vadrianrc/G2-SA253J/diseno_toma_1.pdf

Manantial de Ladera y Concentrado, cuyo rendimiento es el siguiente:

Caudal de Aforo | = | 0.830 | l/s.
Caudal Máximo Diario | = | 0.180 l/s. | (Dato de cálculo de dotación)

1.- Cálculo de la distancia entre el punto de afloramiento y la cámara húmeda (L)

1/2

Donde
h0 = Altura entre el afloramiento y el orificio de entrada (se recomiendan valores de 0.4 a 0.5 m.) g = Aceleración de la gravedad en m/s2
v2 = Velocidad de pase (se recomiendan valores menores o iguales a 0.6 m/s.)
2 x 9.81 | x 0.4 | 0.5
v2 | = | = | 2.2429 m/s.
1.56

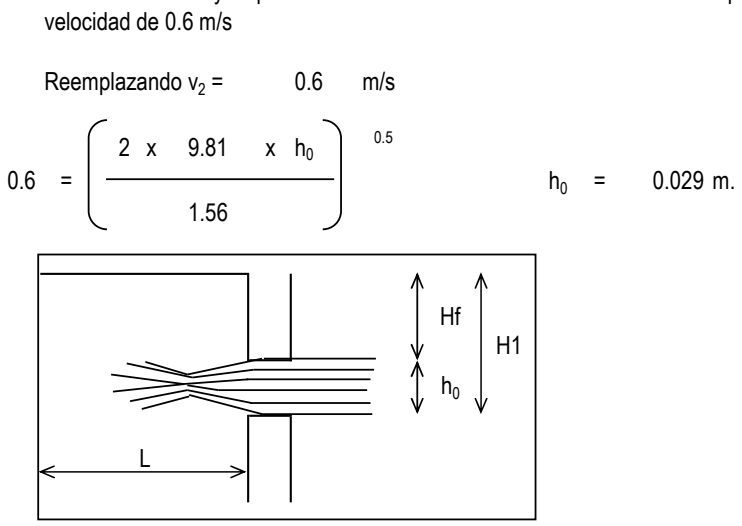
[picture p1: figure]
Reemplazando v2; velocidad de 0.6 m/s

Figura Nro. 01: Carga disponible y perdida de carga En la figura se observa:

"MEJORAMIENTO DEL SISTEMA DE AGUA POTABLE Y ALCANTARILLADO DE LA LOCALIDAD DE PUSACPAMPA, DISTRITO DE COMAS - DISTRITO DE COMAS - PROVINCIA DE CONCEPCION - REGIÓN JUNÍN"

DISEÑO CAPTACIÓN DE LADERA (PUSACPAMPA 1)

2gh0

1.56

v2 =

Dicho valor es mayor que la velocidad máxima recomendada de 0.6 m/s por lo que se asume para el diseño una

"MEJORAMIENTO DEL SISTEMA DE AGUA POTABLE Y ALCANTARILLADO DE LA LOCALIDAD DE PUSACPAMPA, DISTRITO DE COMAS - DISTRITO DE COMAS - PROVINCIA DE CONCEPCION - REGIÓN JUNÍN"

DISEÑO CAPTACIÓN DE LADERA (PUSACPAMPA 1)

Hf = H1 | - | h0 | y | L | = | Hf | / | 0.3
Reemplazando Valores
Hf = | 0.24 - 0.029 = | 0.21 m. | y | L = | 0.21 / 0.3 | = | 0.70 | m.
2.- Ancho de pantalla (b)

Cálculo del diámetro de la tubería de entrada (D)

El valor de área está definida como:

considerando:
Cd | = Coeficiente de descarga | 0.6 | a | 0.8
Qmáx | = | 0.83 l/s.
V | = | 0.60 m/s.
Cd | = | 0.7
Reemplazando valores se obtiene:

### 0.7 x 0.6

El diámetro del orificio está definido mediante:

| 1/2
4 x | 1/2
D = | 5.02 cm. | = | 1.97 "

Calculo del número de orificios (NA)

D Calculado | > D Recomendado
D asum. = | 1 | D recom. | = | 2.54 | cm

D

2
| (3/4 ")

D

4A
π

1.98E-03

1

=

= | = | = | 1.98E-03 1.9762 | l/m.
= | 0.0502 | m.

D

2
(4/7")

m

2

=

### 0.83 A

Qmáx
Cd x V

3.14159 D =

NA = | +

A

"MEJORAMIENTO DEL SISTEMA DE AGUA POTABLE Y ALCANTARILLADO DE LA LOCALIDAD DE PUSACPAMPA, DISTRITO DE COMAS - DISTRITO DE COMAS - PROVINCIA DE CONCEPCION - REGIÓN JUNÍN"

DISEÑO CAPTACIÓN DE LADERA (PUSACPAMPA 1)

25.16
6.45
Cálculo de ancho de pantalla (b) b = 9*D+4*N°A*D
b | = | cm.
Entonces se asume:
b | = | m.

3.- Cálculo de la cámara húmeda (Ht)

Utilizando la ecuación:
Ht = A + B + H + D + E | Min=0.30m
Donde:
A = | 10 cm.
B = | 2.54 cm. 1 | " | Es el diámetro de la tubería de salida a la línea de conducción.
D = | 5 cm.
E = | 30 cm. | Borde libre (min=0.30m)
El valor de la carga requerida (H) se define mediante la ecuación:

### 2 g A

2

Donde:
Qmd | = | m

3
/s. Gasto máximo diario
A | = | m

2
. | Área de la Tuberia de salida
g | = | 9.81 | m/s²
. Aceleración gravitacional Reemplazando Valores se obtiene:

2 9.81

H | = | cm.
H | = | cm. | H=0.30; Altura mínima para facilitar el paso del agua.
NA = | 1 + | = | 4.90 | 4

=

H

Q

2md 1.56

Asumiendose NA =

63.5

0.70

H | 0.0100 | m. 2.56752E-07

Desnivel mínimo entre el ingreso del agua de afloramiento y el nivel de agua de la cámara húmeda.

1.56

=

1.003

30.00

0.00018
0.0005

=

3.24E-08

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

DISEÑO CAPTACIÓN DE LADERA (PUSACPAMPA 1)

Entonces:

Ht | = | + 2.54 + | 30 | + | 5 | + | 30
Ht = | cm. | = | 0.8 m.

En el diseño se considera:

Ht = | | m.

4.- Dimensionamiento de la canastilla

NOTA: Estas dimensiones se obtienen en funcion al caudal Máximo diario que la poblacion requiere.

Qmax diario =

Cálculo del diámetro de la tubería de entrada (D)

El valor de área está definida como:

considerando:
Cd | = Coeficiente de descarga | 0.6 | a | 0.8
Qmáx | = | 0.18 l/s.
V | = | 0.60 m/s.
Cd | = | 0.8
Reemplazando valores se obtiene:

### 0.8 x 0.6

El diámetro del orificio está definido mediante:

| 1/2
4 x | 1/2
=
3.75E-04 | =

0.80

m

2

77.54

0.375 | l/m. | =

=

Qmáx
Cd x V

10

0.180

0.18 | = | 3.75E-04

A

A =

D = 4A
π
D | 0.0219 | m. 3.14159

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

DISEÑO CAPTACIÓN DE LADERA (PUSACPAMPA 1)

D = 2.1851 cm. | = | 0.86 " | = | 1 | Por cálculo hidráulico
D canastilla = | 2 | x | = | 2 "

La longitud de la canastilla debe ser:

3Dc < L < | 6Dc
L = | 3 x | 1.00 = | 7.62 = | 8 cm.
L = | 6 x | 1.00 = | 15.24 = | 15 cm.
L = | 20 cm. | Asumido
Ancho de ranura | = | 10 mm
Largo de ranura | = | 7.5 mm
siendo el área de ranura (Ar) | = | 7.5 | x | 10 = | 75 mm²

Ar =

π | x Dc² | 3.14 | x | 6
At = | 2 x Ac | At | = | 2 x | = | m

2

5.- Rebose y Limpia

0.71 x | Q 0.38 | Hf | = | 0.015 | m/m Perdida de carga unitaria

Hf 0.21

### 0.71 x 0.913 0.38

0.21

Entonces el diámetro de la tubería de rebose será | = | 2 | Pulgada
| | | | = | 2.00

=

At
Ar | 0.000075

m

2

0.00050671 | 0.00101
Ac | = | 4

=

= 14 0.001013415

0.000075

4

= 1.66

0.000507

Nº de ranuras | =

0.015

D =

D =

Ac =

1.00
