vadrianrc/G2-SA253J/aforo_pusacpampa_1.png

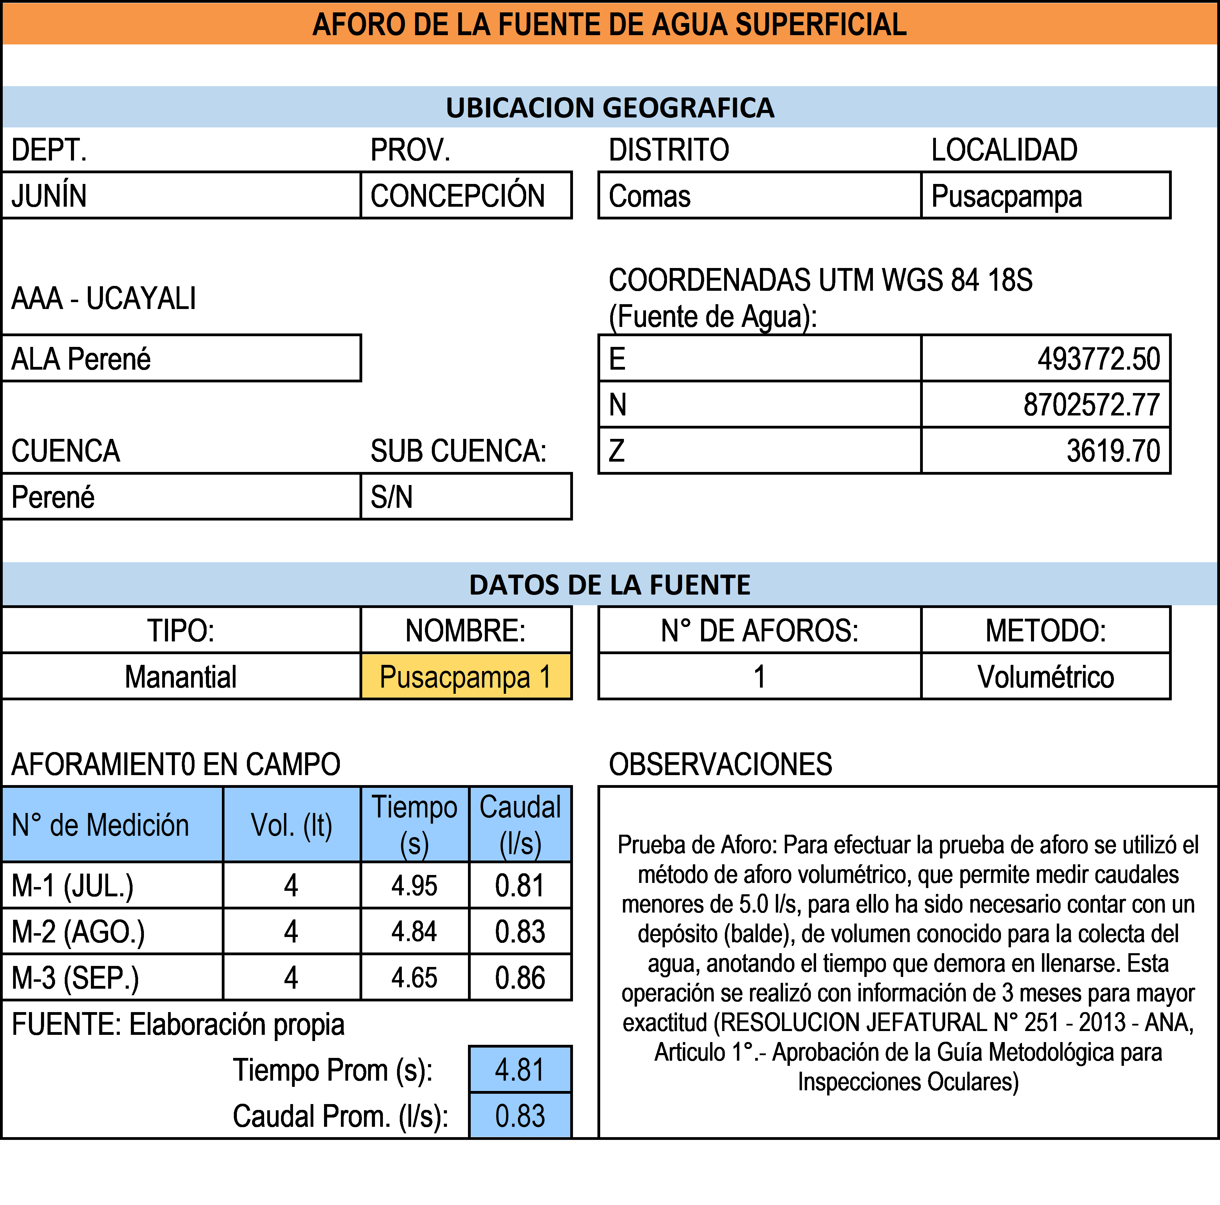
aforo_pusacpampa_1.png
