vadrianrc/G2-SA253J/caseta_cloracion.png

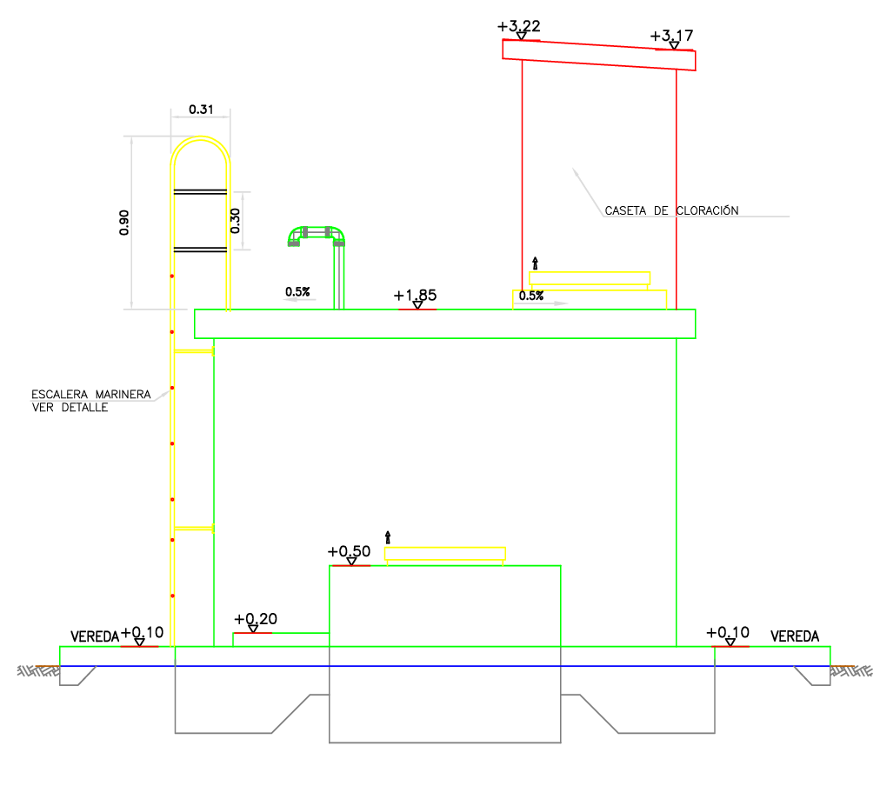
caseta_cloracion.png
