vadrianrc/G2-SA253J/(list of files, cad)

Other CAD files:
Reservorio Apoyado 5 m3.dwg
