vadrianrc/G2-SA253J/reservorio_plano.pdf

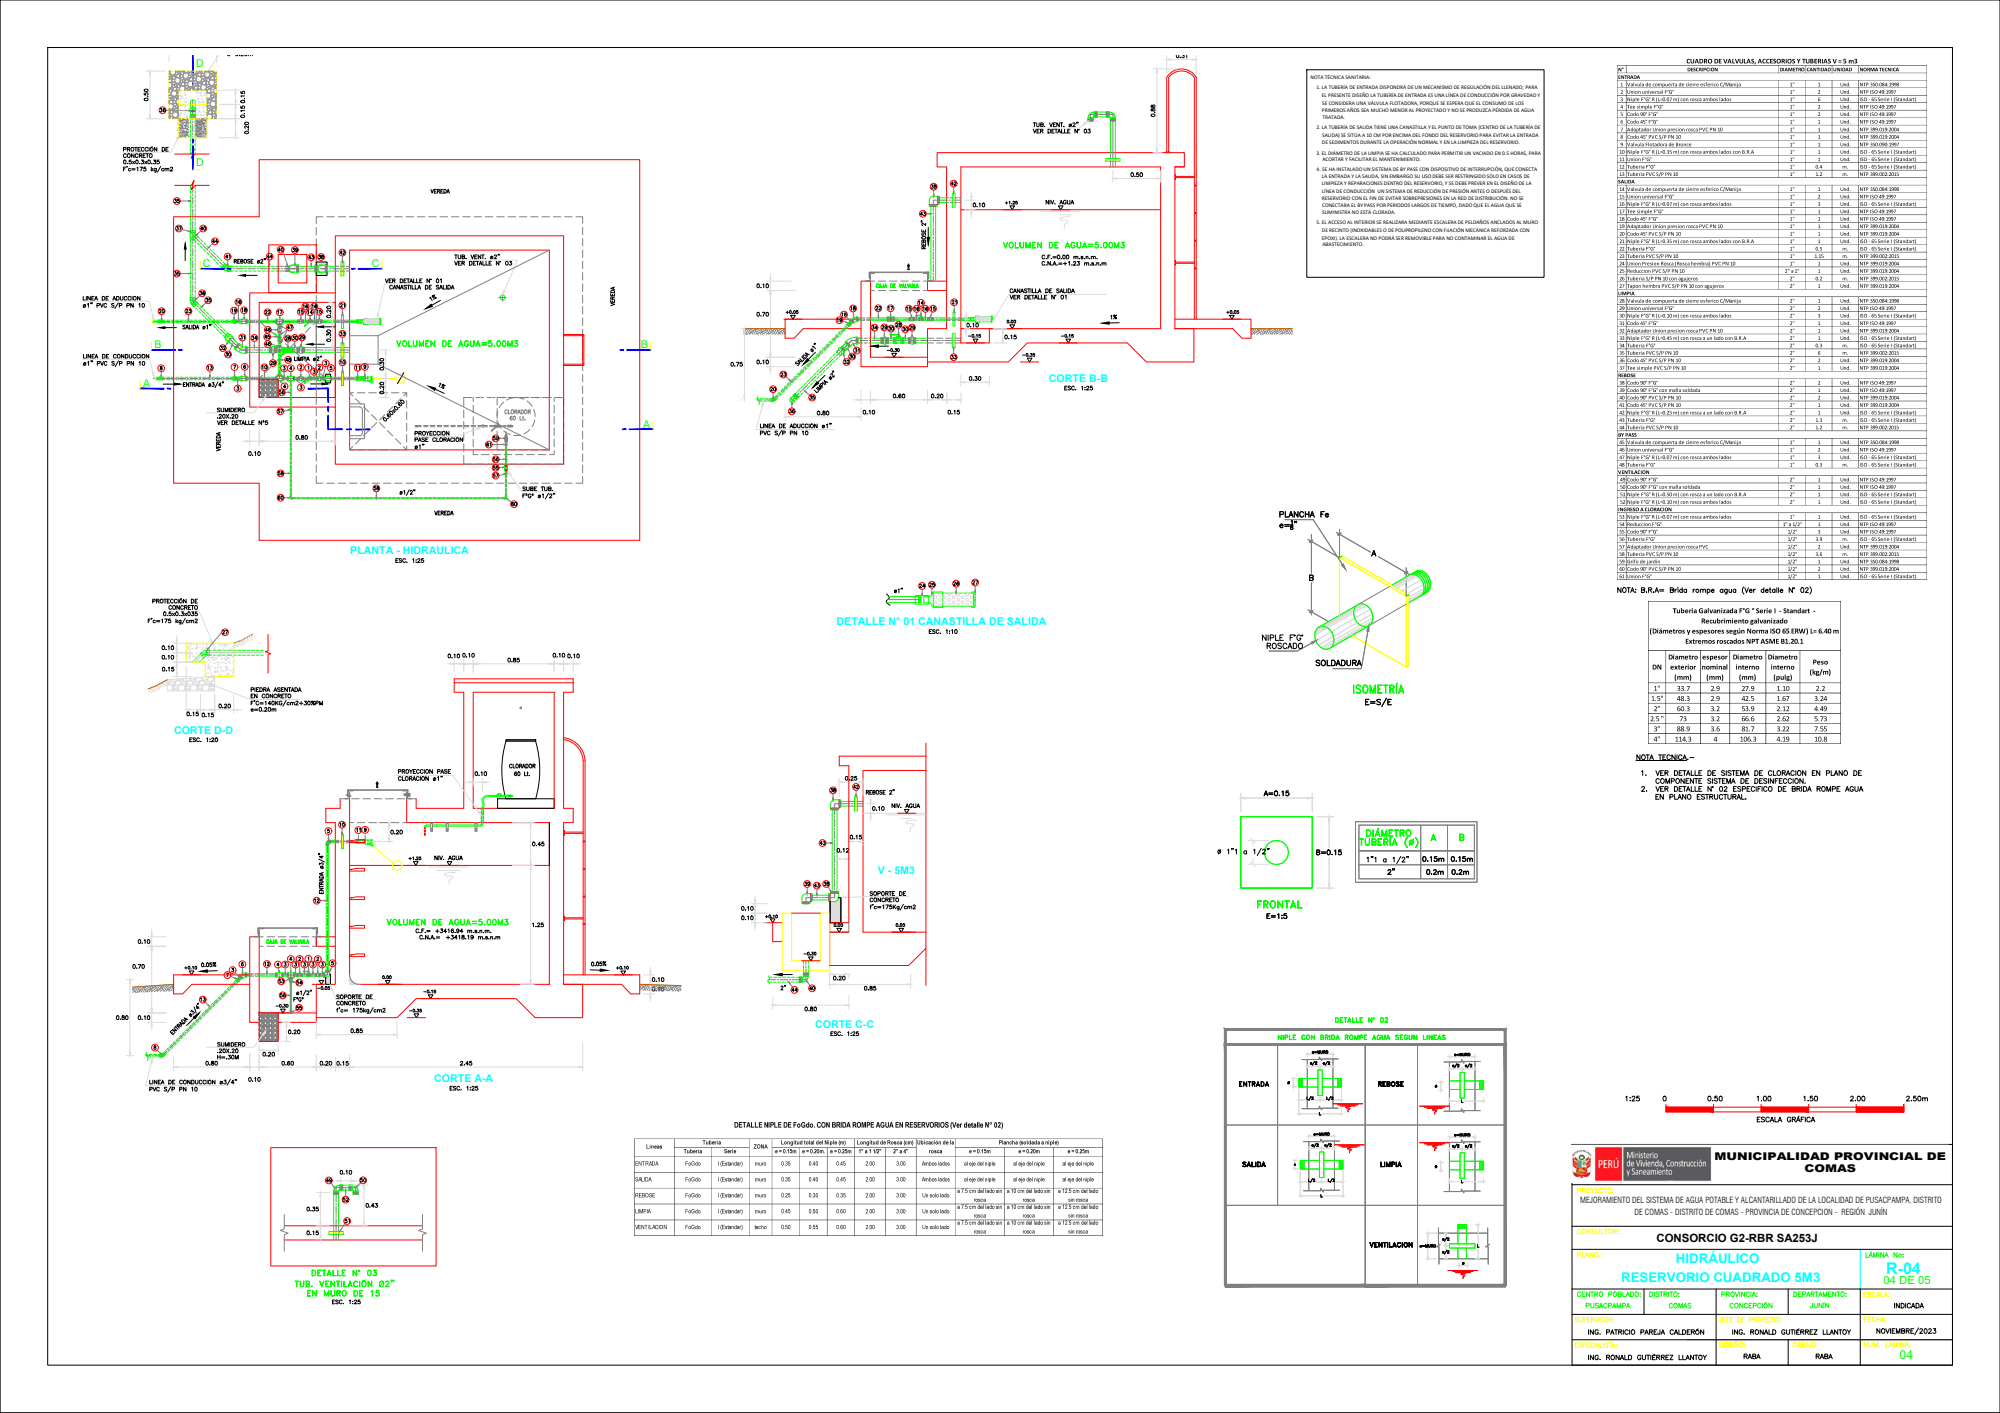
[picture p4: page 1]
CORTE A-A; CORTE B-B; PLANTA - HIDRAULICA; CORTE C-C; CORTE D-D; RESERVORIO CUADRADO 5M3; CONSORCIO G2-RBR SA253J

NOTA TÉCNICA SANITARIA: 1. LA TUBERÍA DE ENTRADA DISPONDRÁ DE UN MECANISMO DE REGULACIÓN DEL LLENADO; PARA

EL PRESENTE DISEÑO LA TUBERÍA DE ENTRADA ES UNA LÍNEA DE CONDUCCIÓN POR GRAVEDAD Y
SE CONSIDERA UNA VÁLVULA FLOTADORA, PORQUE SE ESPERA QUE EL CONSUMO DE LOS
PRIMEROS AÑOS SEA MUCHO MENOR AL PROYECTADO Y NO SE PRODUZCA PÉRDIDA DE AGUA
TRATADA. 2. LA TUBERÍA DE SALIDA TIENE UNA CANASTILLA Y EL PUNTO DE TOMA (CENTRO DE LA TUBERÍA DE

SALIDA) SE SITÚA A 10 CM POR ENCIMA DEL FONDO DEL RESERVORIO PARA EVITAR LA ENTRADA
DE SEDIMENTOS DURANTE LA OPERACIÓN NORMAL Y EN LA LIMPIEZA DEL RESERVORIO. 3. EL DIÁMETRO DE LA LIMPIA SE HA CALCULADO PARA PERMITIR UN VACIADO EN 0.5 HORAS, PARA

ACORTAR Y FACILITAR EL MANTENIMIENTO. 4. SE HA INSTALADO UN SISTEMA DE BY PASS CON DISPOSITIVO DE INTERRUPCIÓN, QUE CONECTA

LA ENTRADA Y LA SALIDA, SIN EMBARGO SU USO DEBE SER RESTRINGIDO SOLO EN CASOS DE
LIMPIEZA Y REPARACIONES DENTRO DEL RESERVORIO, Y SE DEBE PREVER EN EL DISEÑO DE LA
LÍNEA DE CONDUCCIÓN UN SISTEMA DE REDUCCIÓN DE PRESIÓN ANTES O DESPUÉS DEL
RESERVORIO CON EL FIN DE EVITAR SOBREPRESIONES EN LA RED DE DISTRIBUCIÓN. NO SE
CONECTARA EL BY PASS POR PERIODOS LARGOS DE TIEMPO, DADO QUE EL AGUA QUE SE
SUMINISTRA NO ESTÁ CLORADA. 5. EL ACCESO AL INTERIOR SE REALIZARA MEDIANTE ESCALERA DE PELDAÑOS ANCLADOS AL MURO

DE RECINTO (INOXIDABLES O DE POLIPROPILENO CON FIJACIÓN MECÁNICA REFORZADA CON
EPOXI). LA ESCALERA NO PODRÁ SER REMOVIBLE PARA NO CONTAMINAR EL AGUA DE ABASTECIMIENTO.

DETALLE N° 01 CANASTILLA DE SALIDA

MUNICIPALIDAD PROVINCIAL DE

MEJORAMIENTO DEL SISTEMA DE AGUA POTABLE Y ALCANTARILLADO DE LA LOCALIDAD DE PUSACPAMPA, DISTRITO

DE COMAS - DISTRITO DE COMAS - PROVINCIA DE CONCEPCION - REGIÓN JUNÍN
