vadrianrc/G2-SA253J/plano_tomas.pdf

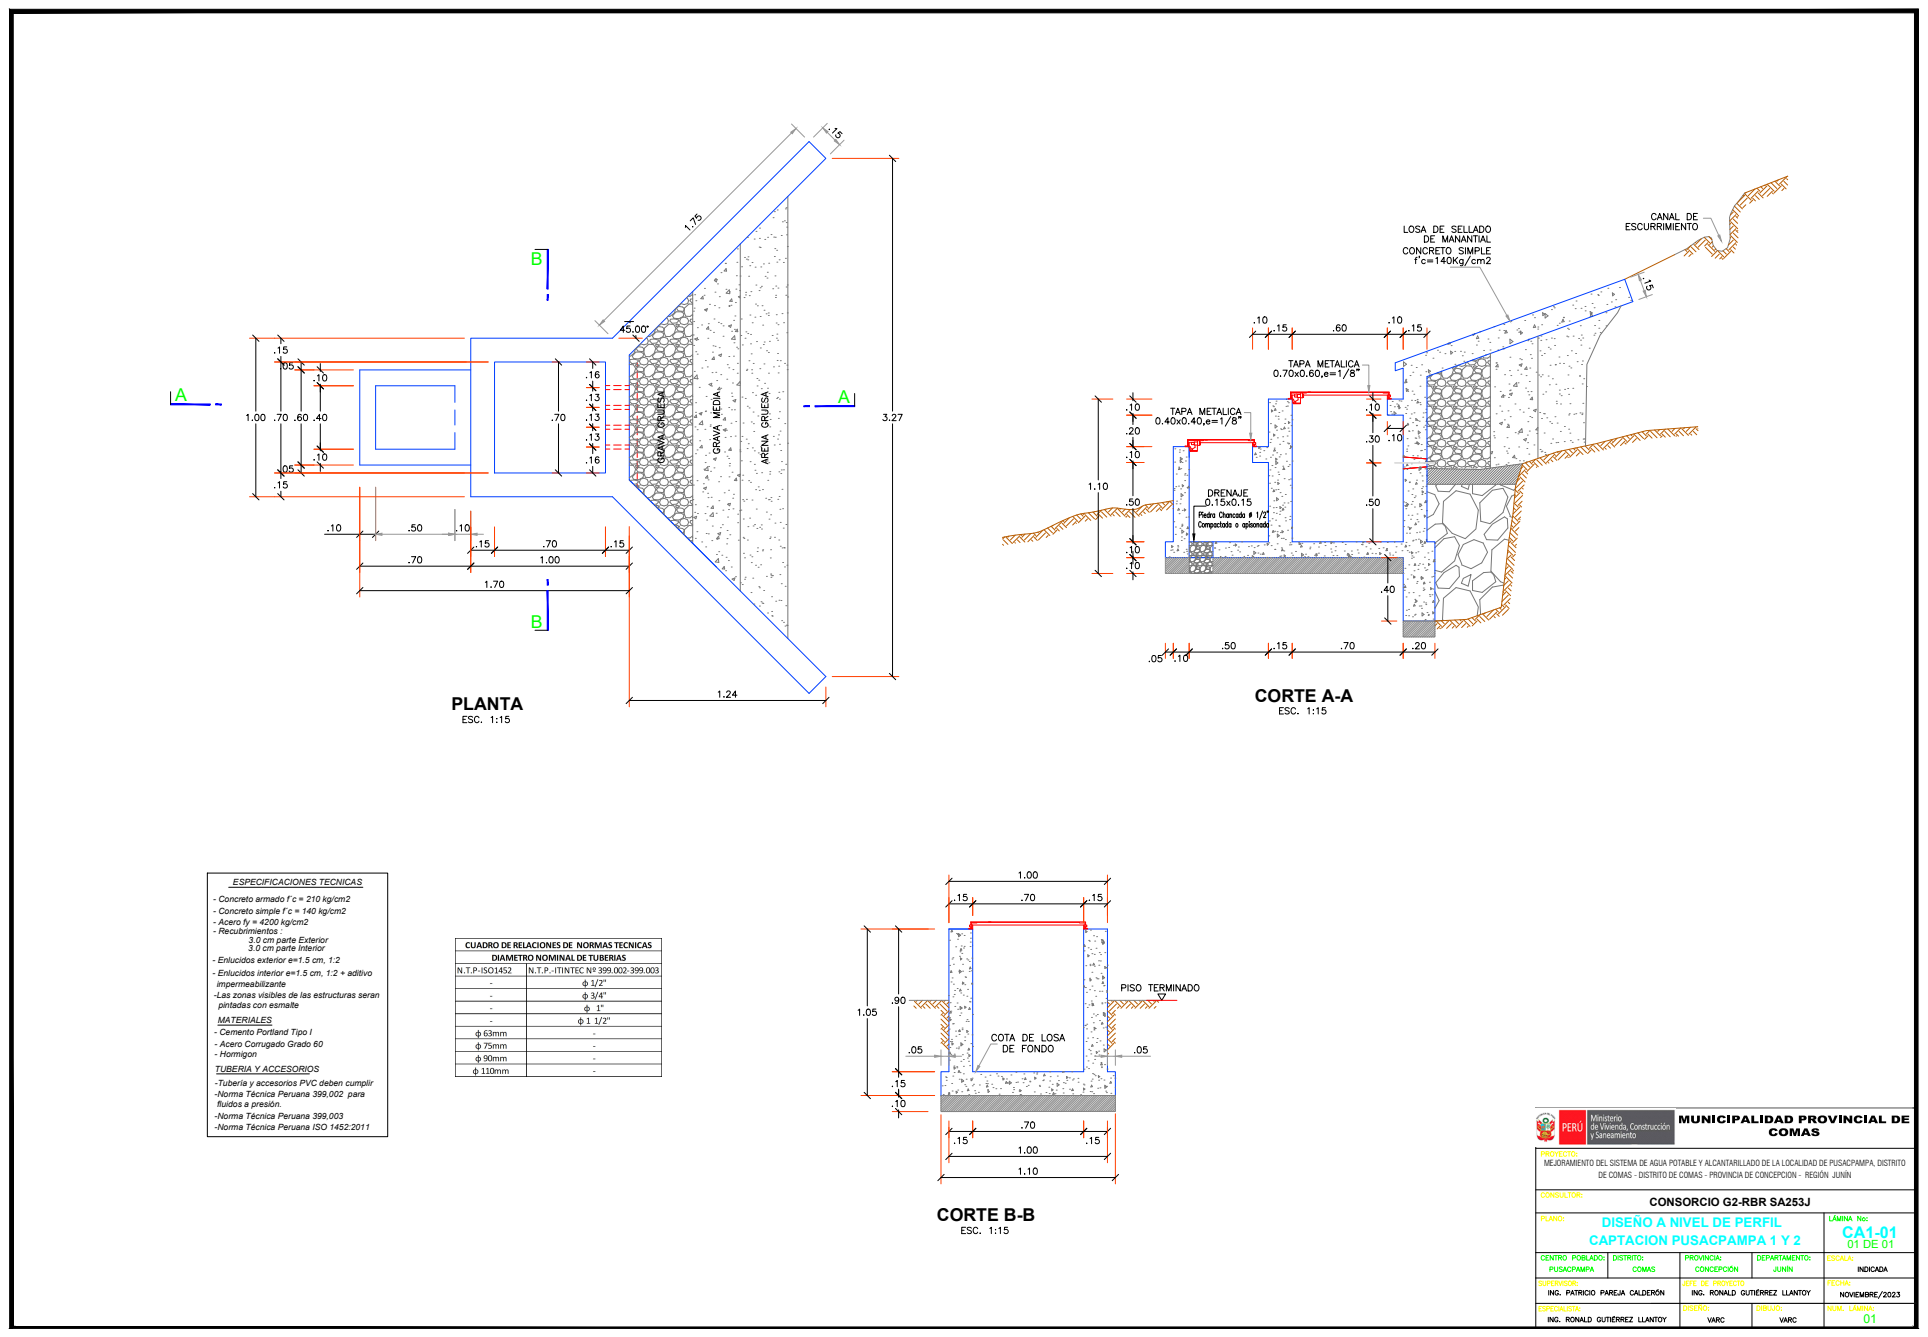
[picture p5: page 1]
CORTE A-A; CORTE B-B; ESPECIFICACIONES TECNICAS; CONSORCIO G2-RBR SA253J; CAPTACION PUSACPAMPA 1 Y 2

- Concreto armado f´c = 210 kg/cm2
- Concreto simple f´c = 140 kg/cm2
- Acero fy = 4200 kg/cm2
- Recubrimientos :

3.0 cm parte Exterior
3.0 cm parte Interior

- Enlucidos exterior e=1.5 cm, 1:2
- Enlucidos interior e=1.5 cm, 1:2 + aditivo
impermeabilizante
-Las zonas visibles de las estructuras seran
pintadas con esmalte

MATERIALES
- Cemento Portland Tipo I
- Acero Corrugado Grado 60
- Hormigon
TUBERIA Y ACCESORIOS
-Tubería y accesorios PVC deben cumplir
-Norma Técnica Peruana 399,002 para
fluidos a presión.
-Norma Técnica Peruana 399,003
-Norma Técnica Peruana ISO 1452:2011

MUNICIPALIDAD PROVINCIAL DE

MEJORAMIENTO DEL SISTEMA DE AGUA POTABLE Y ALCANTARILLADO DE LA LOCALIDAD DE PUSACPAMPA, DISTRITO

DE COMAS - DISTRITO DE COMAS - PROVINCIA DE CONCEPCION - REGIÓN JUNÍN

DISEÑO A NIVEL DE PERFIL
