vadrianrc/G2-SA253J/(commit log)

2023-11-08 Add files via upload
    resources update
    [CH Captacion Lateral Típica.xlsx, Captación de ladera Pusacpampa 1 y 2.dwg]
2023-11-08 Add files via upload
    updating, miss distribution
    [CH Reservorio.xlsx, Reservorio Apoyado 5 m3.dwg]
2023-11-08 Add files via upload
    updatins temptany finished
    [CH Red de Distribución.xlsx]
